sckang2021/esp32mppt/ARDUINO_MPPT_FIRMWARE_V2.1/4_Charging_Algorithm.ino

void buck_Enable(){                                                                  //启用 MPPT 降压转换器
  buckEnable = 1;
  digitalWrite(buck_EN,HIGH);
  digitalWrite(LED,HIGH);
}
void buck_Disable(){                                                                 //禁用 MPPT 降压转换器
  buckEnable = 0; 
  digitalWrite(buck_EN,LOW);
  digitalWrite(LED,LOW);
  PWM = 0;
}   
void predictivePWM(){                                                                //预测PWM 算法 
  if(voltageInput<=0){PPWM=0;}                                                       ///当电压输入为零时防止不确定答案
  else if(voltageOutput>voltageBatteryMax){PPWM =(PPWM_margin*pwmMax*voltageBatteryMax)/(100.00*voltageInput)*0.98;}              //输出电压过大则以电池最大电压为计算基准，防止错误重启充电	20220707
  else{PPWM =(PPWM_margin*pwmMax*voltageOutput)/(100.00*voltageInput);}              //计算预测 PWM Floor 并存储在变量中
  PPWM = constrain(PPWM,0,pwmMaxLimited);
}   

void PWM_Modulation(){
  if(output_Mode==0){PWM = constrain(PWM,0,pwmMaxLimited);}                          //PSU MODE PWM = PWM OVERFLOW PROTECTION（将下限限制为 0%，上限限制为最大允许占空比）
  else{
    predictivePWM();                                                                 //运行和计算预测 pwm floor
    PWM = constrain(PWM,PPWM,pwmMaxLimited);                                         //CHARGER MODE PWM - 将下限限制为 PPWM，上限限制为最大允许占空比）                                     
  } 
  ledcWrite(pwmChannel,PWM);                                                         //设置 PWM 占空比并在启用降压时写入 GPIO
  buck_Enable();                                                                     //开启 MPPT 降压 (IR2104)
}
     
void Charging_Algorithm(){
  if(ERR>0||chargingPause==1){buck_Disable();}                                       //当出现错误或充电暂停用于暂停覆盖时关闭 MPPT 降压
  else{
    if(REC==1){                                                                      // IUV RECOVERY - (仅对充电模式有效)
      REC=0;                                                                         //重置 IUV 恢复布尔标识符
      buck_Disable();                                                                //在 PPWM 初始化之前禁用降压
      //lcd.setCursor(0,0);lcd.print("POWER SOURCE    ");                              //显示液晶信息
      //lcd.setCursor(0,1);lcd.print("DETECTED        ");                              //显示液晶信息
      //tft.fillScreen(TFT_BLACK);
      //tft.drawString("POWER SOURCE DETECTED", 10, 40, 3);
      Serial.println("> Solar Panel Detected");                                      //显示串口信息
      Serial.print("> Computing For Predictive PWM ");                               //显示串口信息
      for(int i = 0; i<40; i++){Serial.print(".");delay(30);}                        //For loop "loading... 效果
      Serial.println("");                                                            //在串行上显示下一行的换行符  
      Read_Sensors();
      predictivePWM();
      PWM = PPWM;
      //lcd.clear();
    }
    else{                                                                            //NO ERROR PRESENT - 继续电源转换
      /////////////////////// CC-CV BUCK PSU ALGORITHM ////////////////////////////// 
      /*
      PSU和cc-cv模式的充电算法问题，充电电流设定值，如果设定值大于输入源额定值，会导致pwm不断增加拉低输入电压直至达到小于电池电压，重启
      如果设定较小值，则无法发挥最大功率
      */
      if(MPPT_Mode==0){                                                              // CC-CV PSU 模式
        //if(PSUcurrentMax>=currentCharging || PSUcurrentMax==0.0000 || currentOutput<0.02){PSUcurrentMax = currentCharging;} //初始化psu输入最大电流
        
        if(currentOutput>currentCharging)     {PWM--;}                             //电流高于限定值 → 降低占空比
		    //psu模式和psu充电模式还是要区别一下，充电模式为了充电可以榨干输入源，psu模式则并不一定需要，所以暂时关闭此判断 20220811
        //if(currentOutput>PSUcurrentMax)       {PWM--;}                               //电流高于外部最大值 → 降低占空比
        else if(voltageOutput>voltageBatteryMax){PWM--;}                             //电压高于 → 降低占空比
        else if(voltageOutput<voltageBatteryMax){PWM++;}                             //当输出低于充电电压时增加占空比（仅用于 CC-CV 模式）
        else{}                                                                       //当达到设定的输出电压时什么都不做 
        PWM_Modulation();                                                            //将 PWM 信号设置为 Buck PWM GPIO
        voltageInputPrev = voltageInput;                                             //	存储先前记录的电压
      }
      ///////////////////////  MPPT & CC-CV 充电算法 ///////////////////////  mppt模式只要防止电压拉低到电池电压保护再进行重启的多余动作
      else{
        if(currentOutput>currentCharging){PWM--;}                                         //电流高于 → 降低占空比
        else if(voltageOutput>voltageBatteryMax){PWM--;}                                  //电压高于 → 降低占空比
        else{                                                                             //MPPT 算法
          if( currentOutput>0.1 && voltageInput>=(voltageOutput+voltageDropout+1)){       //无反向电流，输入大于电池电压的条件下进行pwm处理，阻止过分拉低电压	20220803
            if(powerInput>powerInputPrev && voltageInput>voltageInputPrev)     {PWM--;}   //  ↑P ↑V ; →MPP //D-- 	功率上升且电压上升，继续 抬高电压
            else if(powerInput>powerInputPrev && voltageInput<voltageInputPrev){PWM++;}   //  ↑P ↓V ; MPP← //D++	功率上升且电压降低，继续 拉低电压
            else if(powerInput<powerInputPrev && voltageInput>voltageInputPrev){PWM++;}   //  ↓P ↑V ; MPP→ //D++	功率下降，电压上升，尝试 拉低电压
            else if(powerInput<powerInputPrev && voltageInput<voltageInputPrev){PWM--;}   //  ↓P ↓V ; ←MPP  //D--	功率下降，电压下降，尝试 抬高电压
            else if(voltageOutput>voltageBatteryMax)                           {PWM--;}   //  MP MV ; 达到 MPP 
            else if(voltageOutput<voltageBatteryMax)                           {PWM++;}   //  MP MV ; 达到 MPP 
          }else{
            PWM--;
          }
          
          if(currentOutput<=0){PWM=PWM+2;}  //输出电流负值
          powerInputPrev   = powerInput;                                               //  存储以前记录的功率
          voltageInputPrev = voltageInput;                                             //	存储先前记录的电压
        }
        PWM_Modulation();                                                              //将 PWM 信号设置为 Buck PWM GPIO
      }  
    }
  }
}
