sckang2021/esp32mppt/(commit log)

2022-07-19 新建 ARDUINO_MPPT_FIRMWARE_V2.1
2022-07-19 blinker界面
2022-07-20 新建 libraries
2022-08-05 update ARDUINO_MPPT_FIRMWARE_V2.1/2_Read_Sensors.ino. 修正powerInput,powerOutput的算法bug，之前忽略了分压电阻比例
2022-08-11 update ARDUINO_MPPT_FIRMWARE_V2.1/4_Charging_Algorithm.ino. 更改算法说明
2022-08-11 update ARDUINO_MPPT_FIRMWARE_V2.1/4_Charging_Algorithm.ino.
2022-08-11 新建 ESP32_PV_MPPT
2022-09-01 新建 esp32_buck_boost
2022-09-01 新建 bin
2022-09-01 本程序仅用于buck/boost版本
2022-09-01 boost相关图片
2022-09-01 删除文件 QQ截图20220901153333.png
2022-09-01 flash工具
2022-09-01 重命名 esp32_buck_boost/bin/esp32_buck_boost.bin 为 esp32_buck_boost/bin/esp32_buck_boost_2.0.1.bin
2022-09-01 删除文件 ESP32_PV_MPPT
2022-09-01 删除文件 esp32_buck_boost/bin/esp32_buck_boost_2.0.1.bin
2022-09-03 MPPT buck/boost with INA226 firmware
2022-09-03 删除文件 esp32_buck_boost/bin/esp32_buck_boost_V3.01.bin
2022-09-03 升降压固件
2022-09-07 新建 HW6
2022-09-09 配网设置及OTA界面
2022-09-11 esp32_buck_boost_V3.55 修正bug，改善算法
2022-09-12 删除文件 esp32_buck_boost/bin/HW6/esp32_buck_boost_V3.55.bin
2022-09-12 更改wifi配网顺序，先开机，再配网
2022-09-12 I2C Detect，用于检测INA226地址
2022-09-12 更改wifi配网顺序，先开机，再配网
    增加初始化时检测i2c 地址
    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
2022-09-15 修改配网模式，先联网，再开机
2022-09-19 修复bug若干，修改整个充电算法流程
2022-09-21 重命名 esp32_buck_boost/bin 为 esp32_buck_boost/firmware
2022-09-23 update ARDUINO_MPPT_FIRMWARE_V2.1/ARDUINO_MPPT_FIRMWARE_V2.1.ino.
2022-10-02 esp32_buck_boost_V3.71 buck模式范围控制，理论上修正偶然会出现停止状态
2022-10-04 修改UI界面，增加19-5点深度休眠，整机功耗10ma
2022-10-04 删除文件 esp32_buck_boost/firmware/HW6/esp32_buck_boost_V3.72.bin
2022-10-04 修改ui，增加19-5深度休眠，整机功耗10ma
2022-10-04 修改ui
2022-10-05 新建 HW6_OTA
2022-10-06 修改UI，解决卡屏问题，增加累计电量显示
2022-10-07 增加深度休眠设置，修正bug
2022-10-07 删除文件 esp32_buck_boost/firmware/HW6/esp32_buck_boost_V3.75.bin
2022-10-07 删除文件 esp32_buck_boost/firmware/HW6_OTA/OTA_esp32_buck_boost_V3.75.bin
2022-10-12 改进mppt算法，修正休眠设定的存储
2022-10-12 删除文件 esp32_buck_boost/firmware/HW6/esp32_buck_boost_V3.80.bin
2022-10-12 修复blinker问题，恢复lvgl单缓存，修正休眠自定义保存问题
2022-10-13 blinker UI配置文件
2022-10-13 UI增加日期时间，算法调整
2022-10-13 删除文件 微信图片_20220909130222.jpg
2022-10-13 删除文件 QQ图片20220904165534.jpg
2022-10-14 修正满电过压，满电停充，修改ui界面，充电中，满电状态
2022-10-14 重命名 esp32_buck_boost/firmware/HW6/esp32_buck_boost_V3.4.0.bin 为 esp32_buck_boost/firmware/HW6/esp32_buck_boost_V3.90.bin
2022-10-16 版本号命名修改为3.4.01格式 增加动态风扇开关，可以使用默认的温控开关风扇模式，也可以使用2线风扇温控转速控制
2022-10-18 有更，不知道更了什么
2022-10-18 更了啥，不知道
2022-10-19 增加客户端UI互动，修正输出保护的问题
2022-10-19 删除文件 esp32_buck_boost/firmware/HW6/esp32_buck_boost_V3.51.bin
2022-10-19 删除文件 esp32_buck_boost/firmware/HW6/esp32_buck_boost_V3.56.bin
2022-10-19 删除文件 esp32_buck_boost/firmware/HW6/esp32_buck_boost_V3.65.bin
2022-10-19 删除文件 esp32_buck_boost/firmware/HW6/esp32_buck_boost_V3.69.bin
2022-10-19 删除文件 esp32_buck_boost/firmware/HW6/esp32_buck_boost_V3.70.bin
2022-10-19 删除文件 esp32_buck_boost/firmware/HW6/esp32_buck_boost_V3.71.bin
2022-10-19 新建 GUI
2022-10-22 改善NTP服务连接方式，ntp连接失败可能导致UI界面卡顿 负电流不计入电量
2022-10-24 将工作模式修改为菜单可控制及外部可控制
2022-10-24 适配地址从0x44开始的INA226
2022-10-25 删除文件 esp32_buck_boost/firmware/HW6_OTA/OTA_esp32_buck_boost_V3.74.bin
2022-10-25 删除文件 esp32_buck_boost/firmware/HW6_OTA/OTA_esp32_buck_boost_V3.80.bin
2022-10-25 删除文件 esp32_buck_boost/firmware/HW6_OTA/OTA_esp32_buck_boost_V3.81.bin
2022-10-25 删除文件 esp32_buck_boost/firmware/HW6_OTA/OTA_esp32_buck_boost_V3.82.bin
2022-10-25 删除文件 esp32_buck_boost/firmware/HW6_OTA/OTA_esp32_buck_boost_V3.90.bin
2022-10-28 修正blinker连接问题，增加blinker连接状态，更改菜单退出后延时运行处理，增加意外升压保护
2022-10-30 防止buck模式下意外升压 修改blinker界面的电池电压高低为风扇指示和错误指示
2022-10-31 防止充电过压，防止输入过低
2022-11-03 删除文件 esp32_buck_boost/firmware/HW6_OTA/OTA_esp32_buck_boost_V3.5.06.bin
2022-11-03 删除文件 esp32_buck_boost/firmware/HW6/esp32_buck_boost_V3.5.06.bin
2022-11-03 输出负电流保护
2022-11-04 修正最大输入电压检测逻辑
2022-11-18 BNC状态下，增加电池保护激活
2022-11-21 界面WIFI已连接图标修改为wifi信号强度 界面刷新300ms改为500ms
2022-12-16 增加
    wifi自动连接限定100次，之后每半小时重试
    修正
    boost算法调整，工作最低电压为4v
    BNC状态下电池激活问题
    休眠设置禁用无效问题
    buck模式在某些条件下无法限流问题
2022-12-19 修复buck模式充电问题
2023-01-08 V6.1去除升降压手动开关，将IO17作为输出控制的IO V6.02使用时只需将升降压开关的3个引脚引出即可 电池输出控制基于设定的最低电压，设定为非常闭且电压大于最低电压则深度休眠失效： 1、自动控制：无输入则自动开启输出 2、时间控制：以深度休眠时间作为开启时间 3、手动开关
2023-01-09 20230109
    V6.1去除升降压手动开关，将IO17作为输出控制的IO,开启为低电平，关闭为高电平
    V6.02使用时只需将升降压开关的3个引脚引出即可
    设置页首页双击，可开关输出
    电池输出控制基于设定的最低电压，设定为非常闭且电压大于最低电压则深度休眠失效：
    1、自动控制：无输入则自动开启输出
    2、时间控制：以深度休眠时间作为开启时间
    3、手动开关
2023-01-13 增加动态图表，修正web界面无法显示的问题
2023-01-13 增加输出控制电平设定，可通过菜单设定需要高电平开启还是低电平开启，实际使用根据自己的控制板进行选择
2023-01-29 V3.5.44 更正温度读取bug
2023-02-01 esp32_buck_boost_V3.5.50 更新blinker ui 控制输出及模式切换 修正输出控制
2023-02-05 V3.5.50 修正INA226采样平均数，修正PSU模式算法
2023-02-18 删除文件 README.en.md
2023-02-22 add esp32_buck_boost/readme.md.
2023-02-22 update esp32_buck_boost/readme.md.
2023-02-22 删除文件 esp32_buck_boost/readme.md
2023-03-21 V3.5.62 根据HW6.3版本输入逆流值的问题，调整输入逆流阈值-0.05 增加点灯APP控制ESP32重启
2023-03-22 esp32_buck_boost_V3.5.64 增加ESP32重启原因显示，可从串口获得及web页面显示
2023-03-26 FW: V3.5.66
    修正开启输出低电平时未输出低电平的问题
    修改输出控制逻辑，除使用时间控制时，休眠失效，其他控制模式都会继续使用深度休眠功能，也就是例如：使用常开模式，未进入休眠模式，则输出保持常开，当进入休眠，则关闭输出（此处，如果设定低电平开启，则在休眠状态会输出高电平，但是电平电压为1.6v左右）
2023-07-15 新建 images
2023-07-15 删除文件 images/微信截图_20230715161543.png
2023-07-15 删除文件 images/微信截图_20230715161601.png
2023-07-16 删除文件 images/20230715171002.png
2023-07-16 删除文件 images/20230715171039.png
2023-07-17 删除文件 images/QQ截图20230717145100.png
2023-07-17 V6.45 pcb
2025-09-24 Update and rename 新建 文本文档 (3).txt to 1.txt
